Raucher73/EmbeddedSystems2/(list of files, cad)

Other CAD files:
Gehäuse/Gyrosensor.ipt
Gehäuse/Gyrosensor_Deckel.ipt
Gehäuse/Halterung.ipt
Gehäuse/Konsole.ipt
Gehäuse/Konsole_Deckel.ipt
Gehäuse/OldVersions/Gyrosensor.0004.ipt
Gehäuse/OldVersions/Spiel.0012.ipt
Gehäuse/OldVersions/Spiel_Deckel.0003.ipt
Gehäuse/Spiel.ipt
Gehäuse/Spiel_Deckel.ipt
