Raucher73/EmbeddedSystems2/Pong/src/alpha.h

byte digitMatrix[10][28] = {
    // Ziffer 0
    {1, 1, 1, 1,
     1, 0, 0, 1,
     1, 0, 0, 1,
     1, 0, 0, 1,
     1, 0, 0, 1,
     1, 0, 0, 1,
     1, 1, 1, 1},

    // Ziffer 1
    {0, 0, 0, 1,
     0, 0, 0, 1,
     0, 0, 0, 1,
     0, 0, 0, 1,
     0, 0, 0, 1,
     0, 0, 0, 1,
     0, 0, 0, 1},

    // Ziffer 2
    {1, 1, 1, 1,
     0, 0, 0, 1,
     0, 0, 0, 1,
     1, 1, 1, 1,
     1, 0, 0, 0,
     1, 0, 0, 0,
     1, 1, 1, 1},

    // Ziffer 3
    {1, 1, 1, 1,
     0, 0, 0, 1,
     0, 0, 0, 1,
     1, 1, 1, 1,
     0, 0, 0, 1,
     0, 0, 0, 1,
     1, 1, 1, 1},

    // Ziffer 4
    {1, 0, 0, 1,
     1, 0, 0, 1,
     1, 0, 0, 1,
     1, 1, 1, 1,
     0, 0, 0, 1,
     0, 0, 0, 1,
     0, 0, 0, 1},

    // Ziffer 5
    {1, 1, 1, 1,
     1, 0, 0, 0,
     1, 0, 0, 0,
     1, 1, 1, 1,
     0, 0, 0, 1,
     0, 0, 0, 1,
     1, 1, 1, 1},

    // Ziffer 6
    {1, 1, 1, 1,
     1, 0, 0, 0,
     1, 0, 0, 0,
     1, 1, 1, 1,
     1, 0, 0, 1,
     1, 0, 0, 1,
     1, 1, 1, 1},

    // Ziffer 7
    {1, 1, 1, 1,
     0, 0, 0, 1,
     0, 0, 0, 1,
     0, 0, 0, 1,
     0, 0, 0, 1,
     0, 0, 0, 1,
     0, 0, 0, 1},

    // Ziffer 8
    {1, 1, 1, 1,
     1, 0, 0, 1,
     1, 0, 0, 1,
     1, 1, 1, 1,
     1, 0, 0, 1,
     1, 0, 0, 1,
     1, 1, 1, 1},

    // Ziffer 9
    {1, 1, 1, 1,
     1, 0, 0, 1,
     1, 0, 0, 1,
     1, 1, 1, 1,
     0, 0, 0, 1,
     0, 0, 0, 1,
     1, 1, 1, 1},
};

byte alphaMatrix[8][28]{
    // Buchstabe G
    {1, 1, 1, 1,
     1, 0, 0, 0,
     1, 0, 0, 0,
     1, 0, 1, 1,
     1, 0, 0, 1,
     1, 0, 0, 1,
     1, 1, 1, 1},

    // Buchstabe A
    {1, 1, 1, 1,
     1, 0, 0, 1,
     1, 0, 0, 1,
     1, 1, 1, 1,
     1, 0, 0, 1,
     1, 0, 0, 1,
     1, 0, 0, 1},

    // Buchstabe M
    {1, 0, 0, 1,
     1, 1, 1, 1,
     1, 0, 0, 1,
     1, 0, 0, 1,
     1, 0, 0, 1,
     1, 0, 0, 1,
     1, 0, 0, 1},

    // Buchstabe E
    {1, 1, 1, 1,
     1, 0, 0, 0,
     1, 0, 0, 0,
     1, 1, 1, 1,
     1, 0, 0, 0,
     1, 0, 0, 0,
     1, 1, 1, 1},

    // Buchstabe O
    {1, 1, 1, 1,
     1, 0, 0, 1,
     1, 0, 0, 1,
     1, 0, 0, 1,
     1, 0, 0, 1,
     1, 0, 0, 1,
     1, 1, 1, 1},

    // Buchstabe V
    {1, 0, 0, 1,
     1, 0, 0, 1,
     1, 0, 0, 1,
     1, 0, 0, 1,
     1, 0, 0, 1,
     1, 0, 0, 1,
     0, 1, 1, 0},

    // Buchstabe E
    {1, 1, 1, 1,
     1, 0, 0, 0,
     1, 0, 0, 0,
     1, 1, 1, 1,
     1, 0, 0, 0,
     1, 0, 0, 0,
     1, 1, 1, 1},

    // Buchstabe R
    {1, 1, 1, 1,
     1, 0, 0, 1,
     1, 0, 0, 1,
     1, 1, 1, 1,
     1, 1, 0, 0,
     1, 0, 1, 0,
     1, 0, 0, 1},
};
